mfpeticco/joga-neck/images/joga_neck_render_back.png

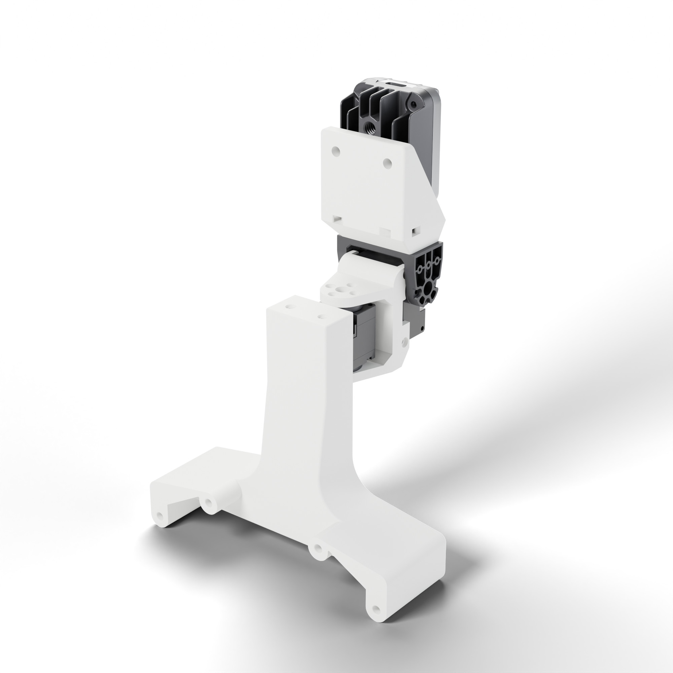
images/joga_neck_render_back.png
