mfpeticco/joga-neck/images/joga_neck_render_side.png

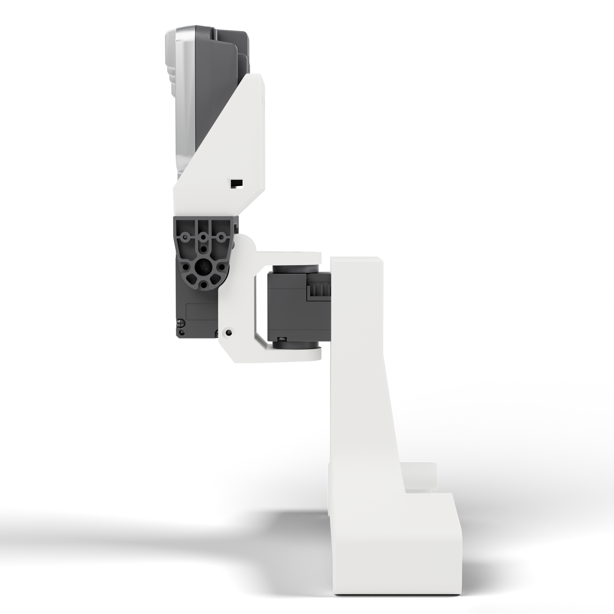
images/joga_neck_render_side.png
