mfpeticco/joga-neck/unitree/images/joga_neck_unitree_render_back.png

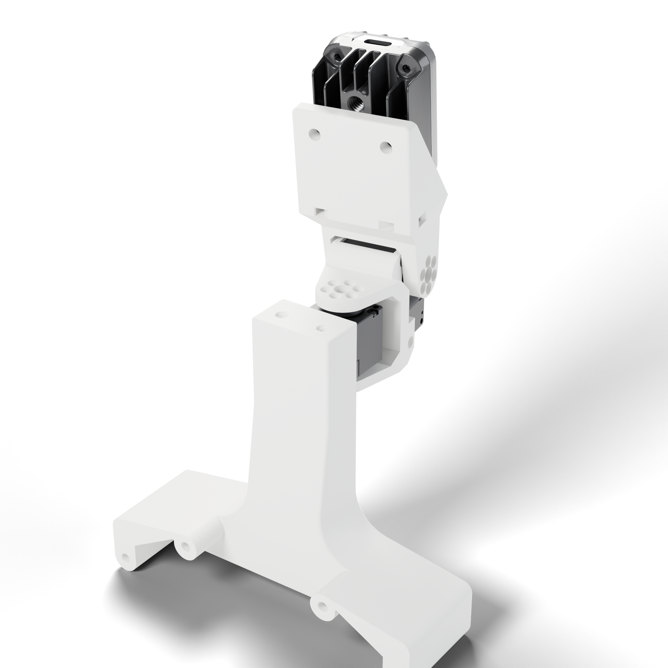
unitree/images/joga_neck_unitree_render_back.png
