mfpeticco/joga-neck/BOM.md

# Bill of Materials

Quantities are for one neck.

## Purchased parts

| Qty | Part | Notes |
|---:|---|---|
| 2 | [DYNAMIXEL XC330-M288-T](https://www.robotis.us/dynamixel-xc330-m288-t/) | Yaw and pitch servos, 5 V |
| 1 | [ROBOTIS U2D2](https://www.robotis.us/u2d2/) | USB interface for the servos |
| 1 | [U2D2 Power Hub Board](https://www.robotis.us/u2d2-power-hub-board-set/) | Powers the servo bus |
| 1 | [DROK 12 V to 5 V converter](https://www.amazon.com/dp/B0D141CZMZ) | Steps the G1's 12 V down to 5 V |
| 1 | [Luxonis OAK-1 W](https://shop.luxonis.com/products/oak-1-w) | Camera |
| 1 | [Locking USB-C cable](https://www.amazon.com/dp/B0DCNFS6F2) | Camera to your computer |
| 1 | USB cable | U2D2 to your computer |
| 2 | DYNAMIXEL 3-pin cables | Power Hub to yaw servo, yaw servo to pitch servo |
| 1 | XT30 male plug or pigtail | G1 12 V port |
| ~1 m | 16–18 AWG silicone wire | Power runs |

## Printed parts

| Qty | Part | File |
|---:|---|---|
| 1 | Torso Mount | [`torso_mount.stl`](stl/torso_mount.stl) |
| 1 | Yaw-Pitch Bracket | [`yaw_pitch_bracket.stl`](stl/yaw_pitch_bracket.stl) |
| 1 | Output Bracket | [`output_bracket.stl`](stl/output_bracket.stl) |
| 1 | Camera Mount | [`camera_mount.stl`](stl/camera_mount.stl) |

## Fasteners

| Qty | Fastener | Where |
|---:|---|---|
| As needed | M2 screws (included with the servos) | Servos and horns to the printed parts, Output Bracket to Camera Mount |
| 2 | M4 × 10 mm | OAK-1 W to the Camera Mount |
