mfpeticco/joga-neck/dynamixel/urdf/g1/assets/left_foot_hull.obj

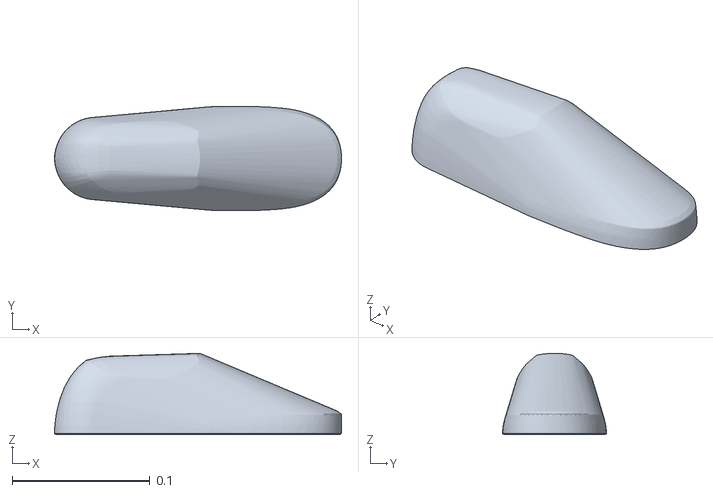
[picture p8: CAD file, 2026-11-08]
dynamixel/urdf/g1/assets/left_foot_hull.obj
0.208 x 0.0756 x 0.059
