mfpeticco/joga-neck/dynamixel/urdf/meshes/output_bracket.stl

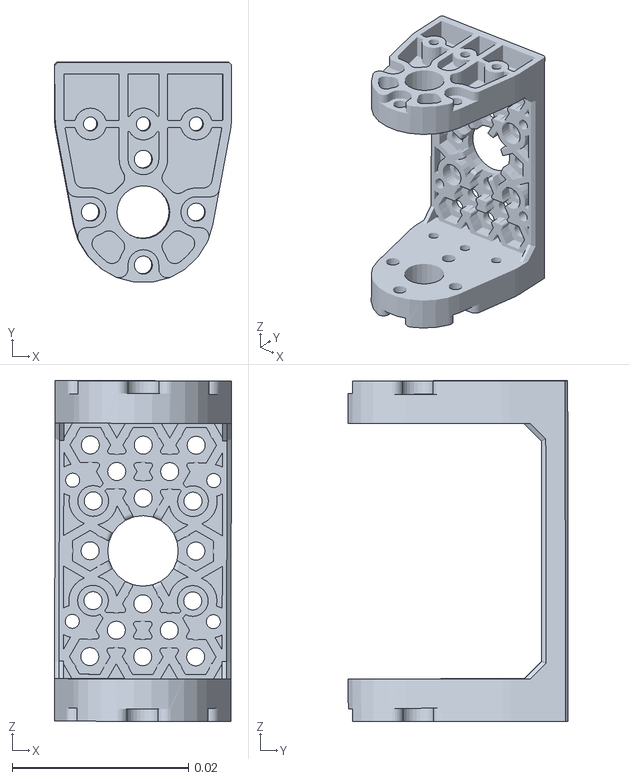
[picture p9: CAD file, 2026-11-08]
dynamixel/urdf/meshes/output_bracket.stl
0.0201 x 0.025 x 0.0387
