mfpeticco/joga-neck/unitree/urdf/meshes/_609_00001_ADHESIVE.stl

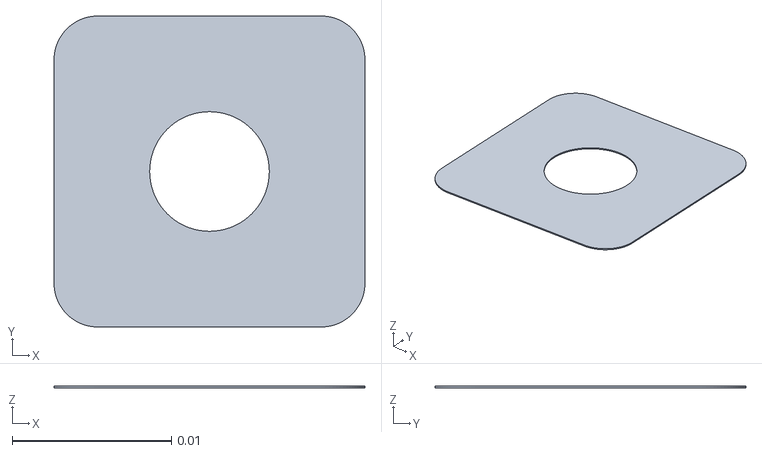
[picture p13: CAD file, 2026-11-08]
unitree/urdf/meshes/_609_00001_ADHESIVE.stl
0.0195 x 0.0195 x 0.0001
