mfpeticco/joga-neck/urdf/meshes/B3B_EH.stl

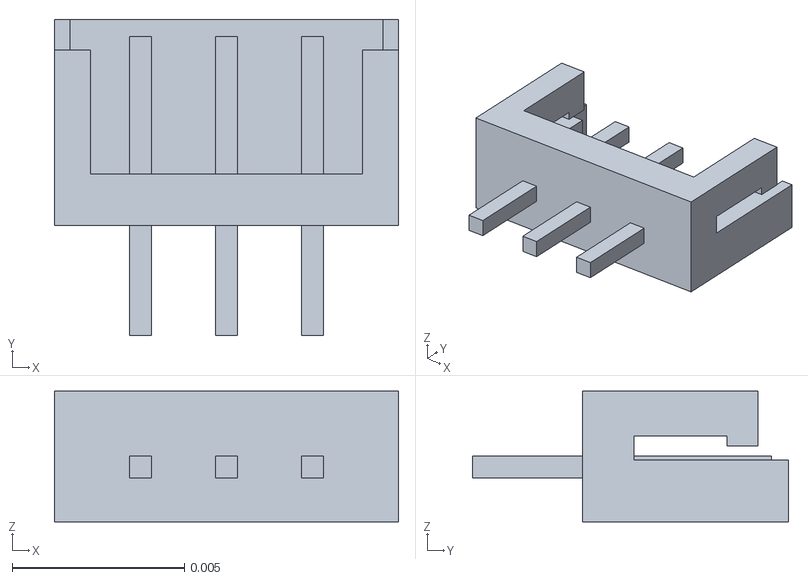
[picture p14: CAD file, 2026-10-20]
urdf/meshes/B3B_EH.stl
0.01 x 0.0092 x 0.0038
