mfpeticco/joga-neck/dynamixel/stl/torso_mount.stl

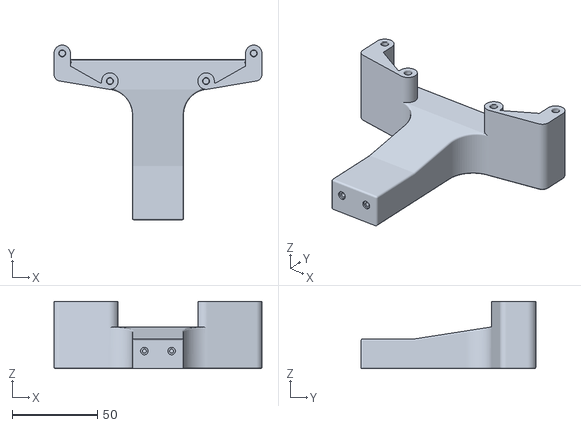
[picture p15: CAD file, 2026-11-08]
dynamixel/stl/torso_mount.stl
122.2 x 102.7 x 39.5
