mfpeticco/joga-neck/dynamixel/urdf/meshes/_609_00001_LENS.stl

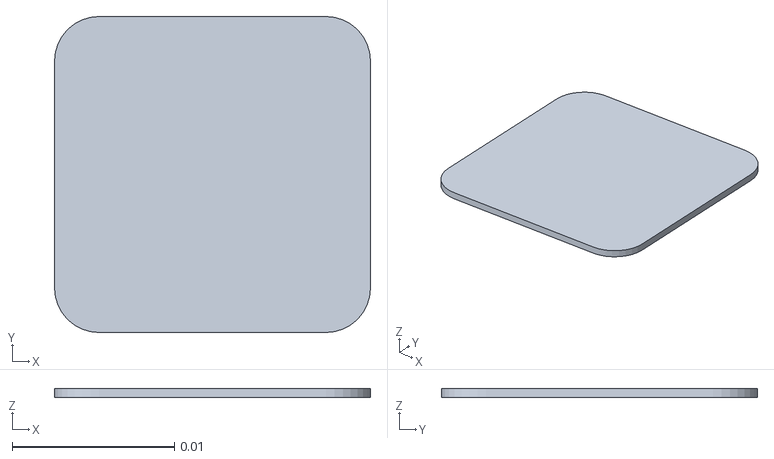
[picture p16: CAD file, 2026-11-08]
dynamixel/urdf/meshes/_609_00001_LENS.stl
0.0195 x 0.0195 x 0.00056
