mfpeticco/joga-neck/stl/output_bracket.stl

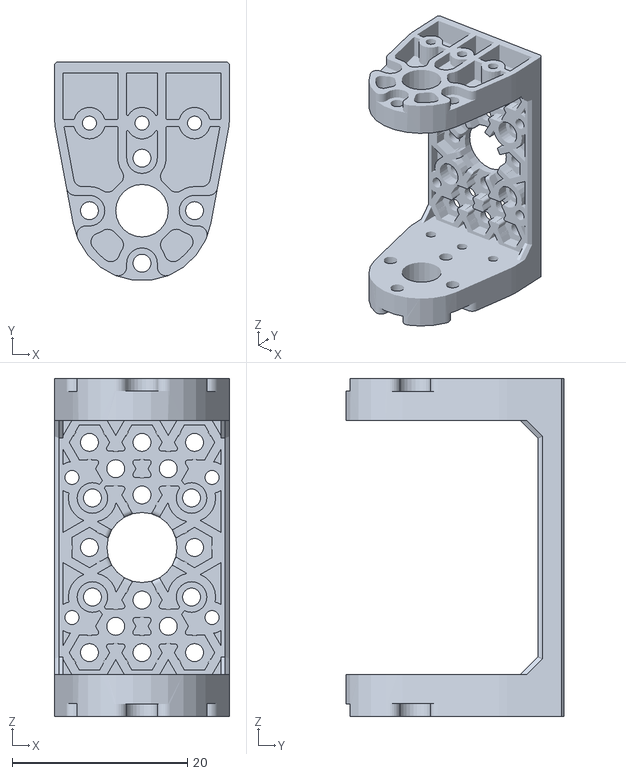
[picture p17: CAD file, 2026-10-20]
stl/output_bracket.stl
20.0 x 24.9 x 38.6
