mfpeticco/joga-neck/unitree/urdf/meshes/_606_00002_REV3.stl

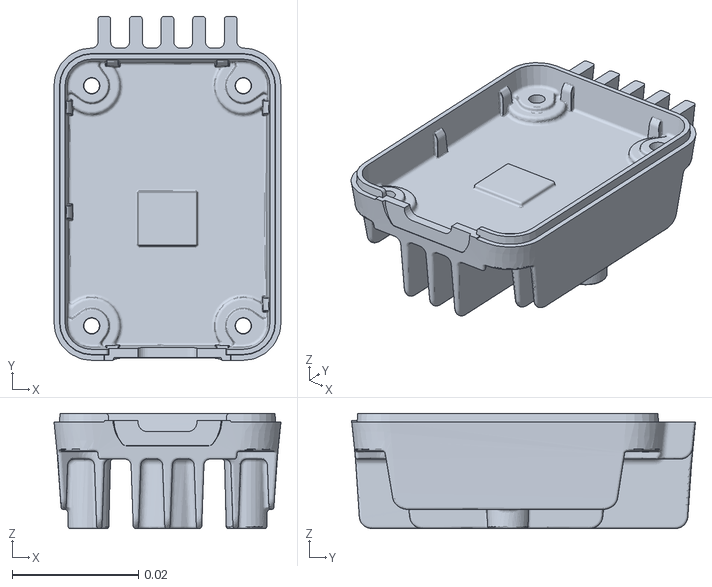
[picture p19: CAD file, 2026-11-08]
unitree/urdf/meshes/_606_00002_REV3.stl
0.0359 x 0.0545 x 0.0182
