mfpeticco/joga-neck/urdf/meshes/PHS_1_7X20_5_DC10.stl

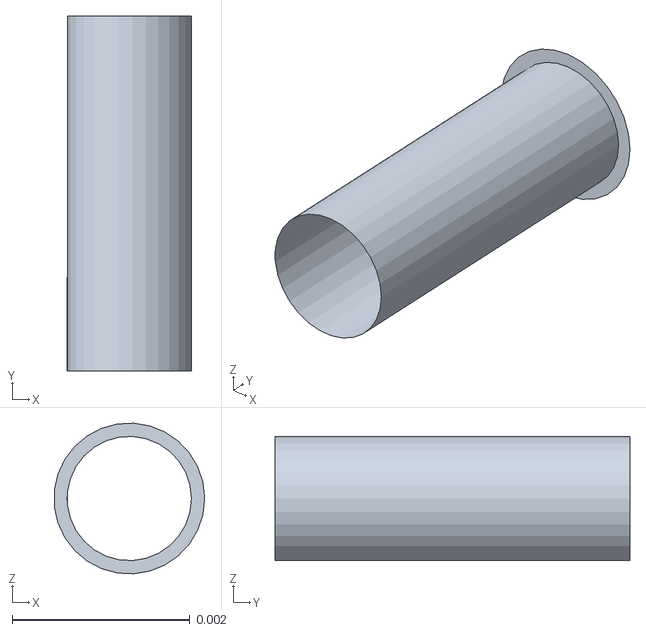
[picture p20: CAD file, 2026-10-20]
urdf/meshes/PHS_1_7X20_5_DC10.stl
0.0017 x 0.004 x 0.0017
