mfpeticco/joga-neck/dynamixel/urdf/meshes/_606_00001_REV3.stl

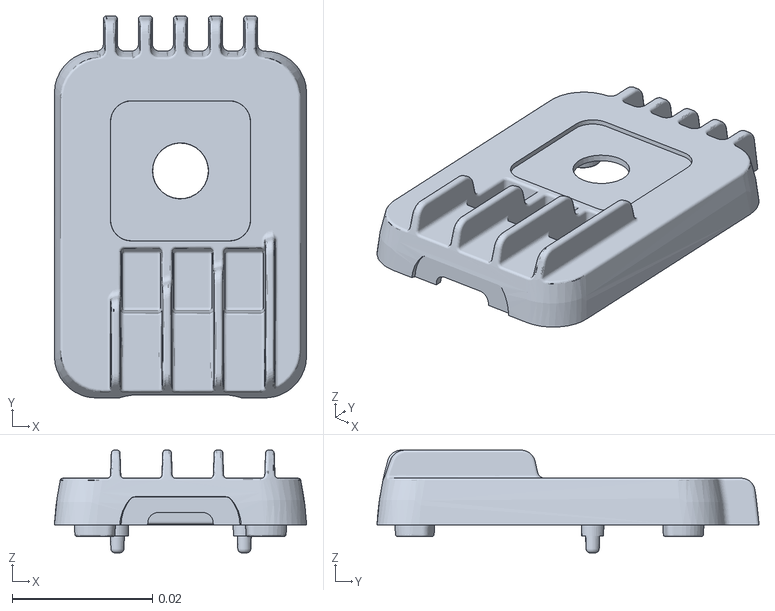
[picture p21: CAD file, 2026-11-08]
dynamixel/urdf/meshes/_606_00001_REV3.stl
0.036 x 0.0545 x 0.0147
