mfpeticco/joga-neck/urdf/meshes/yaw_pitch_bracket.stl

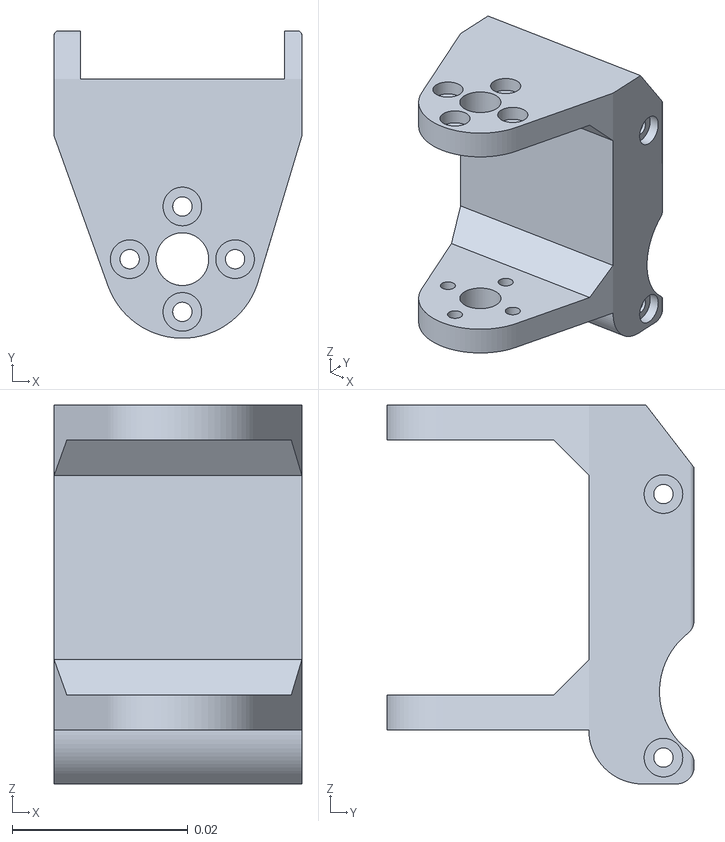
[picture p24: CAD file, 2026-10-20]
urdf/meshes/yaw_pitch_bracket.stl
0.0282 x 0.035 x 0.0431
