mfpeticco/joga-neck/dynamixel/urdf/meshes/DC15_A01_HORN_DUMMY.stl

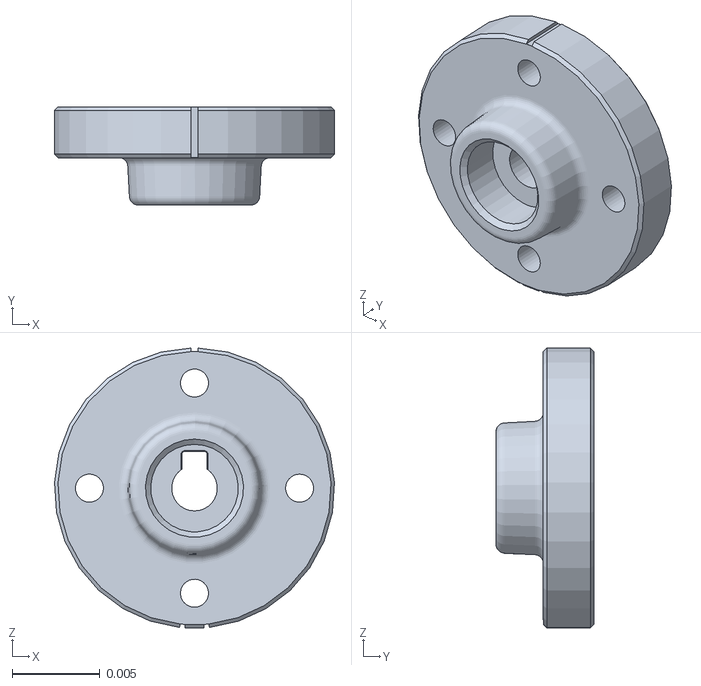
[picture p25: CAD file, 2026-11-08]
dynamixel/urdf/meshes/DC15_A01_HORN_DUMMY.stl
0.016 x 0.0056 x 0.016
