mfpeticco/joga-neck/urdf/meshes/DC15_A01_LED_CAP2_DUMMY.stl

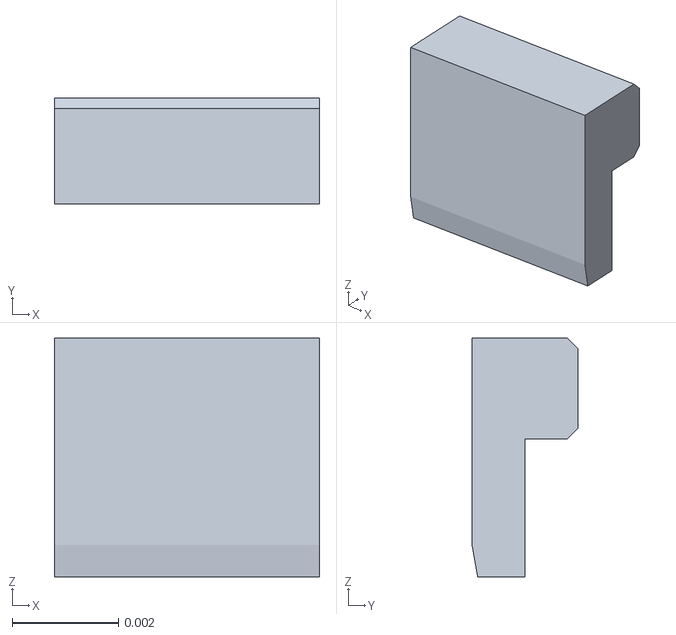
[picture p26: CAD file, 2026-10-20]
urdf/meshes/DC15_A01_LED_CAP2_DUMMY.stl
0.005 x 0.002 x 0.0045
