mfpeticco/joga-neck/urdf/meshes/PHS_1_7X20_5_DC10_1.stl

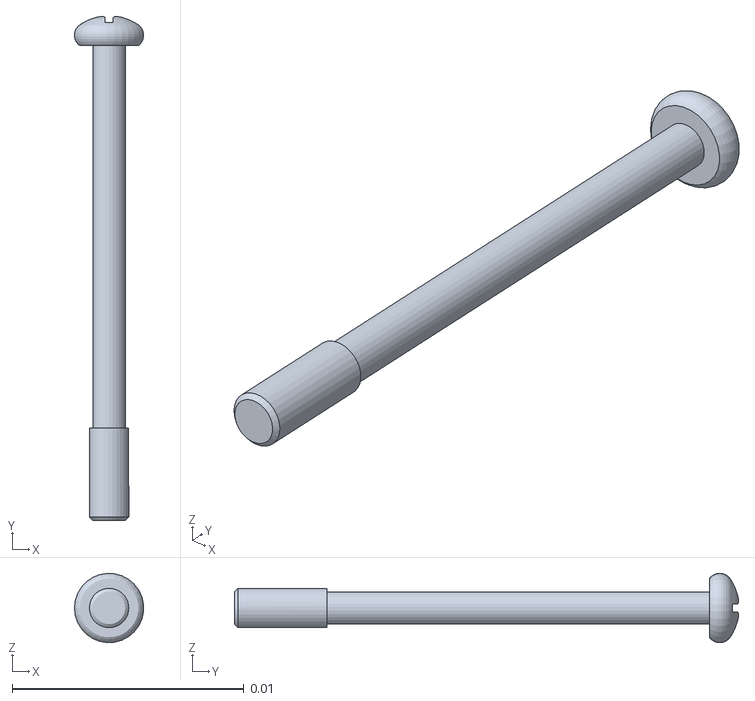
[picture p29: CAD file, 2026-10-20]
urdf/meshes/PHS_1_7X20_5_DC10_1.stl
0.00299 x 0.0218 x 0.00299
