mfpeticco/joga-neck/urdf/meshes/DC15_A01_CASE_B_DUMMY.stl

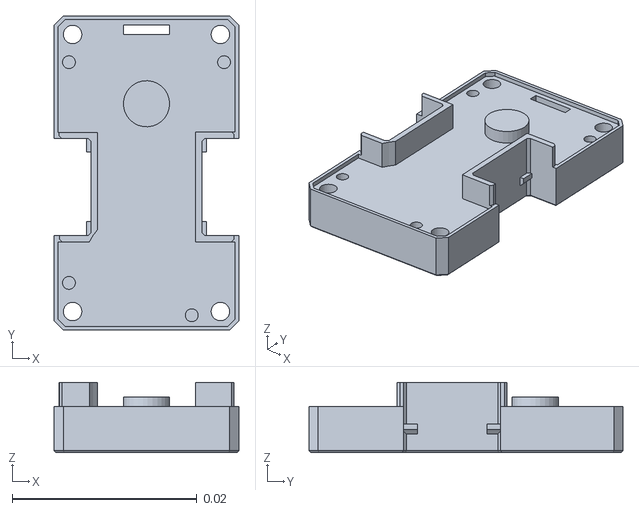
[picture p31: CAD file, 2026-10-20]
urdf/meshes/DC15_A01_CASE_B_DUMMY.stl
0.02 x 0.034 x 0.0076
