mfpeticco/joga-neck/dynamixel/urdf/meshes/BTS2_M2_6X8_1.stl

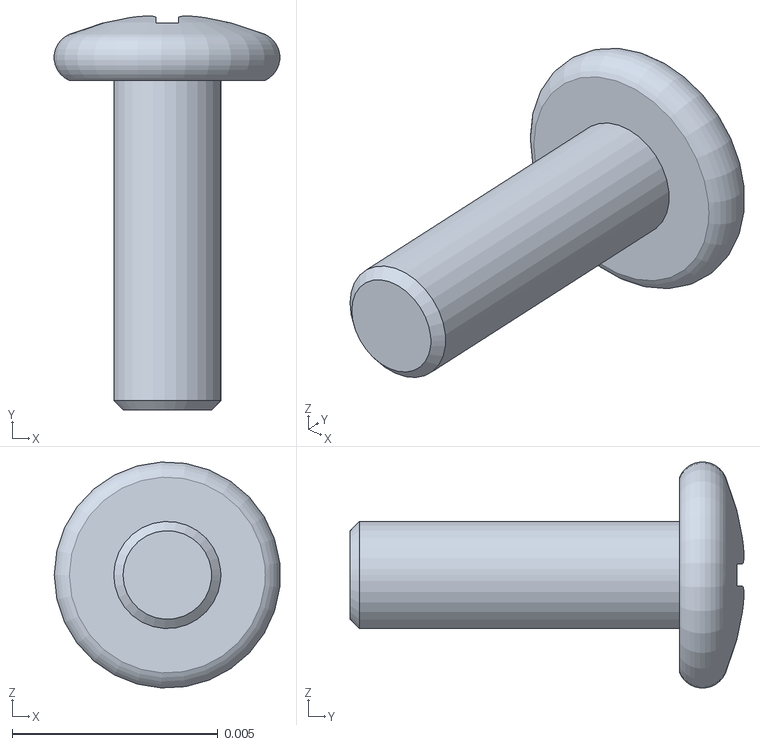
[picture p32: CAD file, 2026-11-08]
dynamixel/urdf/meshes/BTS2_M2_6X8_1.stl
0.00548 x 0.00957 x 0.00549
