mfpeticco/joga-neck/unitree/urdf/meshes/unitree_j288.stl

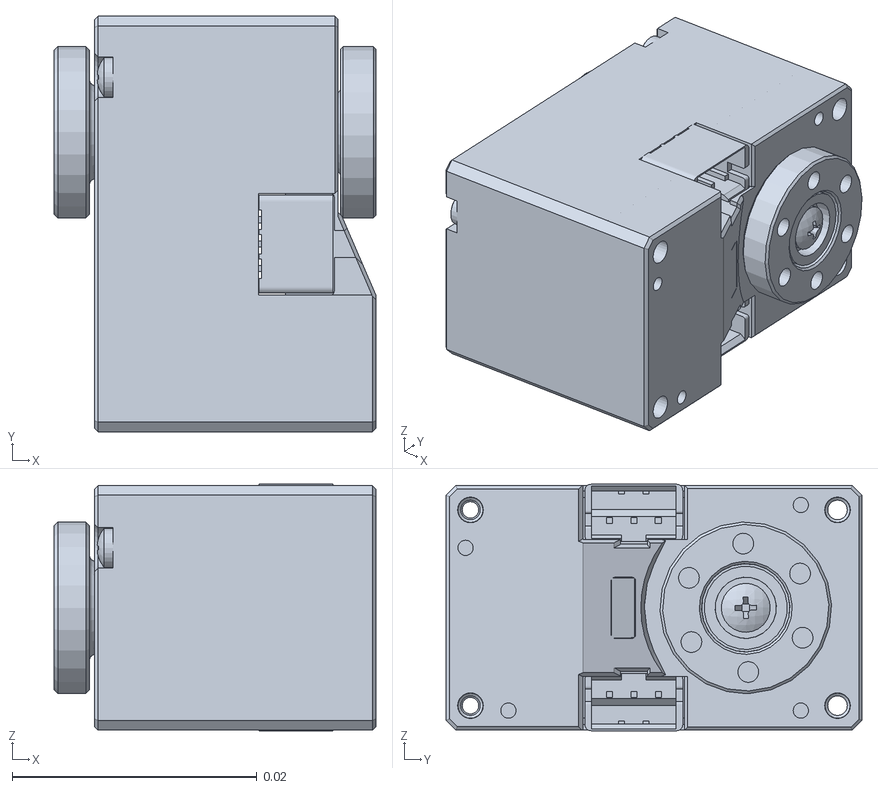
[picture p33: CAD file, 2026-11-08]
unitree/urdf/meshes/unitree_j288.stl
0.0263 x 0.034 x 0.0202
