mfpeticco/joga-neck/dynamixel/urdf/meshes/BTS2_M2_6X8.stl

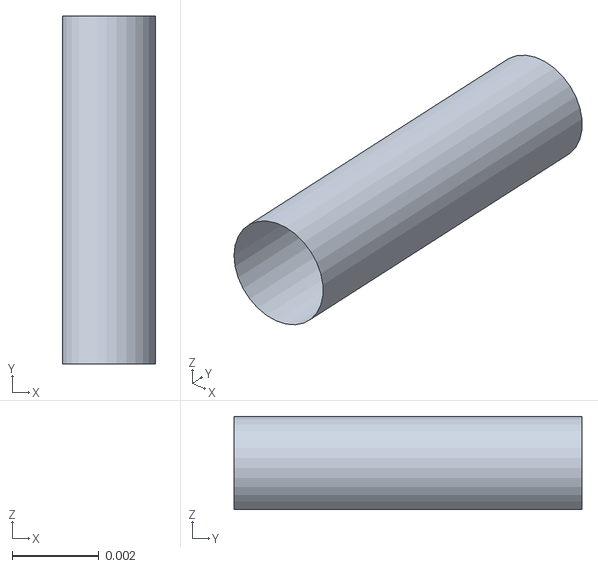
[picture p35: CAD file, 2026-11-08]
dynamixel/urdf/meshes/BTS2_M2_6X8.stl
0.00214 x 0.008 x 0.00215
