mfpeticco/joga-neck/urdf/meshes/DC15_A01_CASE_M_DUMMY.stl

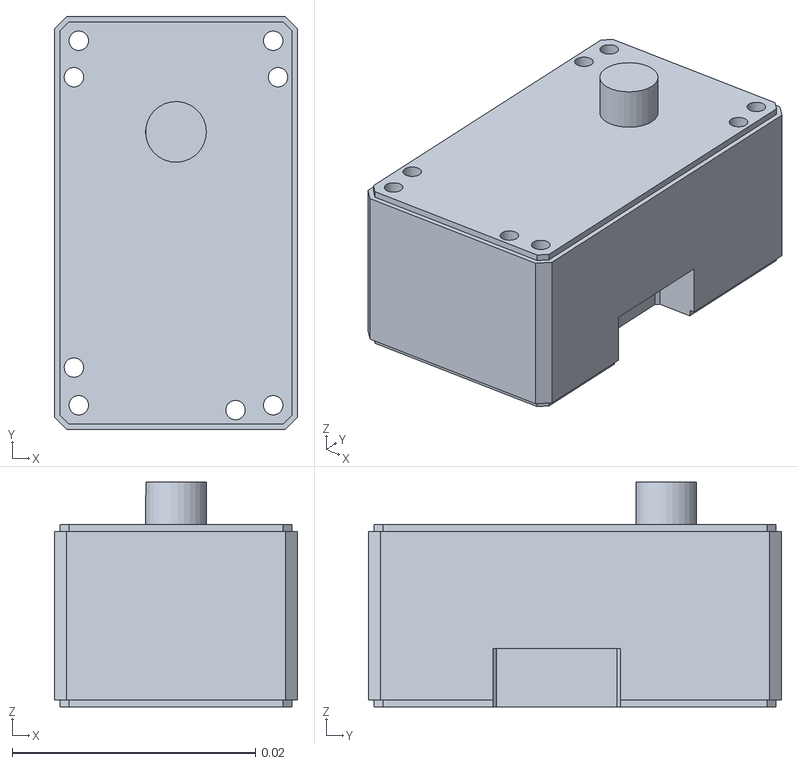
[picture p36: CAD file, 2026-10-20]
urdf/meshes/DC15_A01_CASE_M_DUMMY.stl
0.02 x 0.034 x 0.0185
