mfpeticco/joga-neck/dynamixel/urdf/meshes/DC15_A01_IDLE_CAP_DUMMY.stl

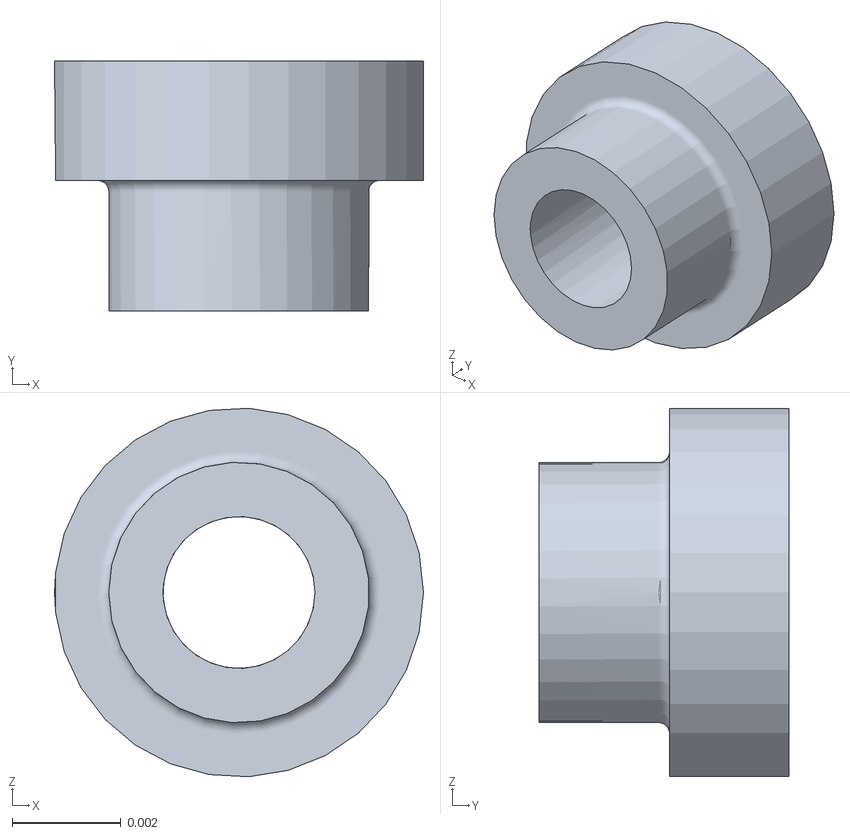
[picture p37: CAD file, 2026-11-08]
dynamixel/urdf/meshes/DC15_A01_IDLE_CAP_DUMMY.stl
0.0068 x 0.0046 x 0.00679
