mfpeticco/joga-neck/dynamixel/urdf/meshes/OakMount.stl

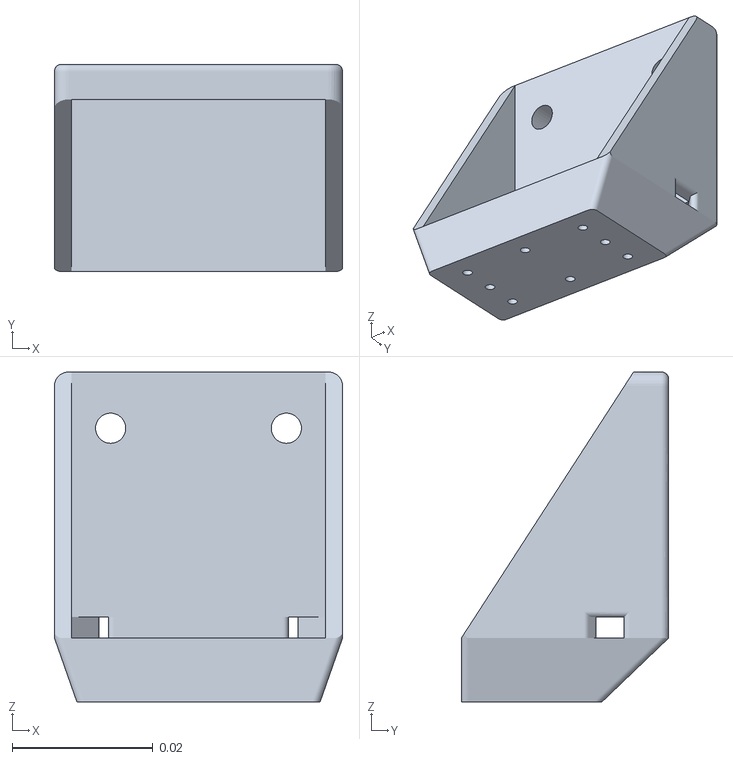
[picture p38: CAD file, 2026-11-08]
dynamixel/urdf/meshes/OakMount.stl
0.041 x 0.0295 x 0.047
