mfpeticco/joga-neck/dynamixel/urdf/meshes/DC15_A01_CASE_F_DUMMY.stl

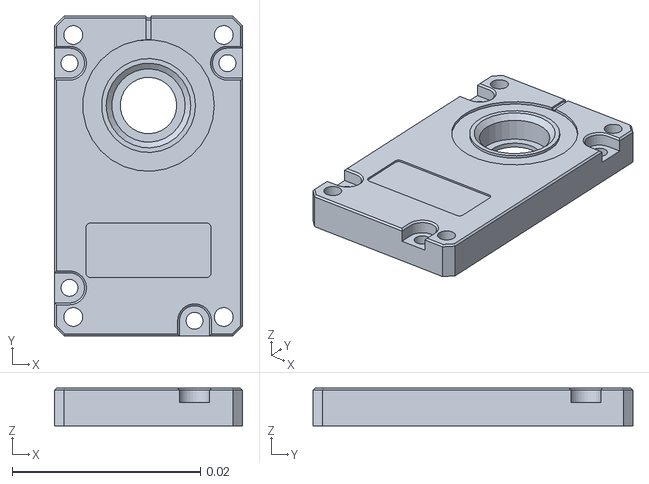
[picture p39: CAD file, 2026-11-08]
dynamixel/urdf/meshes/DC15_A01_CASE_F_DUMMY.stl
0.02 x 0.034 x 0.004
