mfpeticco/joga-neck/(list of files, cad)

Other CAD files:
unitree/urdf/g1/assets/right_foot_hull.obj
unitree/urdf/meshes/_606_00001_REV3.stl
dynamixel/urdf/meshes/_606_00002_REV3.stl
unitree/urdf/meshes/_609_00001_LENS.stl
urdf/meshes/_609_00001_ADHESIVE.stl
