mfpeticco/joga-neck/urdf/joga_neck.urdf

<?xml version="1.0" encoding="utf-8"?>
<!-- Joga Neck: 2-DoF pan-tilt camera neck for the Unitree G1 (https://joga.csail.mit.edu/neck/).
     The kinematics, camera frame, and mass properties are the model used to train the Joga policies,
     with one link per rigid body. Units: m, kg, rad.
     revolute_1 = pan (+ = look left), revolute_2 = tilt (+ = look down).
     Attach `root` to the G1 torso; g1/g1_joga_neck.xml does this at the calibrated mount pose. -->
<robot name="joga_neck">
  <mujoco>
    <compiler meshdir="meshes/" strippath="true" discardvisual="false" fusestatic="false" />
  </mujoco>
  <!-- Torso Mount and the pan (yaw) servo body. Attach this link to the G1 torso. -->
  <link name="root">
    <inertial>
      <origin xyz="-1.88947806e-06 -0.0165475179 0.0317838142" rpy="0 0 0" />
      <mass value="0.0569618527" />
      <inertia ixx="7.7620303e-05" ixy="-4.87390976e-10" ixz="5.97099333e-09" iyy="0.00010172899" iyz="2.08546722e-05" izz="4.81920637e-05" />
    </inertial>
    <visual name="b3b_eh_2">
      <origin xyz="0.00770000053 -0.0277000144 0.0674000122" rpy="1.57079367 6.32680464e-06 1.57080265" />
      <geometry>
        <mesh filename="meshes/B3B_EH.stl" />
      </geometry>
      <material name="b3b_eh_2_material">
        <color rgba="0.301961 0.301961 0.301961 1" />
      </material>
    </visual>
    <visual name="b3b_eh_3">
      <origin xyz="-0.00769999947 -0.0277001118 0.0673999713" rpy="1.57080163 -8.98039444e-06 -1.57079" />
      <geometry>
        <mesh filename="meshes/B3B_EH.stl" />
      </geometry>
      <material name="b3b_eh_3_material">
        <color rgba="0.301961 0.301961 0.301961 1" />
      </material>
    </visual>
    <visual name="bts2_m2_6x8_4">
      <origin xyz="-2.9190209e-09 -0.0366999696 0.0777000487" rpy="1.57079 -2.65358275e-06 2.65360658e-06" />
      <geometry>
        <mesh filename="meshes/BTS2_M2_6X8.stl" />
      </geometry>
      <material name="bts2_m2_6x8_4_material">
        <color rgba="0.301961 0.301961 0.301961 1" />
      </material>
    </visual>
    <visual name="bts2_m2_6x8_5">
      <origin xyz="-2.9190209e-09 -0.0366999696 0.0777000487" rpy="1.57079 -2.65358275e-06 2.65360658e-06" />
      <geometry>
        <mesh filename="meshes/BTS2_M2_6X8_1.stl" />
      </geometry>
      <material name="bts2_m2_6x8_5_material">
        <color rgba="0.301961 0.301961 0.301961 1" />
      </material>
    </visual>
    <visual name="bts2_m2_6x8_6">
      <origin xyz="0 -0.0367001415 0.0521000487" rpy="-1.57079 -7.04153879e-12 -3.14159" />
      <geometry>
        <mesh filename="meshes/BTS2_M2_6X8_1.stl" />
      </geometry>
      <material name="bts2_m2_6x8_6_material">
        <color rgba="0.301961 0.301961 0.301961 1" />
      </material>
    </visual>
    <visual name="bts2_m2_6x8_7">
      <origin xyz="0 -0.0367001415 0.0521000487" rpy="-1.57079 -7.04153879e-12 -3.14159" />
      <geometry>
        <mesh filename="meshes/BTS2_M2_6X8.stl" />
      </geometry>
      <material name="bts2_m2_6x8_7_material">
        <color rgba="0.301961 0.301961 0.301961 1" />
      </material>
    </visual>
    <visual name="dc15_a01_case_b_dummy_1">
      <origin xyz="0 -0.0367 0.0765000597" rpy="3.14159 0 0" />
      <geometry>
        <mesh filename="meshes/DC15_A01_CASE_B_DUMMY.stl" />
      </geometry>
      <material name="dc15_a01_case_b_dummy_1_material">
        <color rgba="0.301961 0.301961 0.301961 1" />
      </material>
    </visual>
    <visual name="dc15_a01_case_f_dummy_1">
      <origin xyz="0 -0.0367000517 0.0570000597" rpy="3.14159 0 0" />
      <geometry>
        <mesh filename="meshes/DC15_A01_CASE_F_DUMMY.stl" />
      </geometry>
      <material name="dc15_a01_case_f_dummy_1_material">
        <color rgba="0.301961 0.301961 0.301961 1" />
      </material>
    </visual>
    <visual name="dc15_a01_case_m_dummy_1">
      <origin xyz="0 -0.0367000517 0.0570000597" rpy="3.14159 0 0" />
      <geometry>
        <mesh filename="meshes/DC15_A01_CASE_M_DUMMY.stl" />
      </geometry>
      <material name="dc15_a01_case_m_dummy_1_material">
        <color rgba="0.301961 0.301961 0.301961 1" />
      </material>
    </visual>
    <visual name="dc15_a01_horn_dummy_1">
      <origin xyz="0 -0.0367000613 0.0534000597" rpy="-1.57079 -7.04153879e-12 -3.14159" />
      <geometry>
        <mesh filename="meshes/DC15_A01_HORN_DUMMY.stl" />
      </geometry>
      <material name="dc15_a01_horn_dummy_1_material">
        <color rgba="0.301961 0.301961 0.301961 1" />
      </material>
    </visual>
    <visual name="dc15_a01_horn_idle2_dummy_1">
      <origin xyz="0 -0.0366999865 0.0766000487" rpy="-1e-05 -2.65358275e-06 2.65360658e-06" />
      <geometry>
        <mesh filename="meshes/DC15_A01_HORN_IDLE2_DUMMY.stl" />
      </geometry>
      <material name="dc15_a01_horn_idle2_dummy_1_material">
        <color rgba="0.301961 0.301961 0.301961 1" />
      </material>
    </visual>
    <visual name="dc15_a01_idle_cap_dummy_1">
      <origin xyz="-7.16478016e-09 -0.0366999595 0.0793000487" rpy="1.57079 -2.65358275e-06 2.65360658e-06" />
      <geometry>
        <mesh filename="meshes/DC15_A01_IDLE_CAP_DUMMY.stl" />
      </geometry>
      <material name="dc15_a01_idle_cap_dummy_1_material">
        <color rgba="0.301961 0.301961 0.301961 1" />
      </material>
    </visual>
    <visual name="dc15_a01_led_cap2_dummy_1">
      <origin xyz="1.99017168e-08 -0.0441999272 0.0746001072" rpy="1e-05 -7.04153879e-12 -3.14159" />
      <geometry>
        <mesh filename="meshes/DC15_A01_LED_CAP2_DUMMY.stl" />
      </geometry>
      <material name="dc15_a01_led_cap2_dummy_1_material">
        <color rgba="0.301961 0.301961 0.301961 1" />
      </material>
    </visual>
    <visual name="phs_1_7x20_5_dc10_10">
      <origin xyz="0.00840001194 -0.0412001009 0.0550000772" rpy="-1.57079 -7.04153879e-12 -3.14159" />
      <geometry>
        <mesh filename="meshes/PHS_1_7X20_5_DC10.stl" />
      </geometry>
      <material name="phs_1_7x20_5_dc10_10_material">
        <color rgba="0.301961 0.301961 0.301961 1" />
      </material>
    </visual>
    <visual name="phs_1_7x20_5_dc10_11">
      <origin xyz="-0.00840005148 -0.0173001455 0.0549999259" rpy="-1.57079 -7.04153879e-12 -3.14159" />
      <geometry>
        <mesh filename="meshes/PHS_1_7X20_5_DC10.stl" />
      </geometry>
      <material name="phs_1_7x20_5_dc10_11_material">
        <color rgba="0.301961 0.301961 0.301961 1" />
      </material>
    </visual>
    <visual name="phs_1_7x20_5_dc10_12">
      <origin xyz="0.00489993923 -0.0138001102 0.0549999038" rpy="-1.57079 -7.04153879e-12 -3.14159" />
      <geometry>
        <mesh filename="meshes/PHS_1_7X20_5_DC10_1.stl" />
      </geometry>
      <material name="phs_1_7x20_5_dc10_12_material">
        <color rgba="0.301961 0.301961 0.301961 1" />
      </material>
    </visual>
    <visual name="phs_1_7x20_5_dc10_13">
      <origin xyz="-0.00839998806 -0.0412001455 0.0550000772" rpy="-1.57079 -7.04153879e-12 -3.14159" />
      <geometry>
        <mesh filename="meshes/PHS_1_7X20_5_DC10.stl" />
      </geometry>
      <material name="phs_1_7x20_5_dc10_13_material">
        <color rgba="0.301961 0.301961 0.301961 1" />
      </material>
    </visual>
    <visual name="phs_1_7x20_5_dc10_14">
      <origin xyz="-0.00840005148 -0.0173001455 0.0549999259" rpy="-1.57079 -7.04153879e-12 -3.14159" />
      <geometry>
        <mesh filename="meshes/PHS_1_7X20_5_DC10_1.stl" />
      </geometry>
      <material name="phs_1_7x20_5_dc10_14_material">
        <color rgba="0.301961 0.301961 0.301961 1" />
      </material>
    </visual>
    <visual name="phs_1_7x20_5_dc10_15">
      <origin xyz="0.00840001194 -0.0412001009 0.0550000772" rpy="-1.57079 -7.04153879e-12 -3.14159" />
      <geometry>
        <mesh filename="meshes/PHS_1_7X20_5_DC10_1.stl" />
      </geometry>
      <material name="phs_1_7x20_5_dc10_15_material">
        <color rgba="0.301961 0.301961 0.301961 1" />
      </material>
    </visual>
    <visual name="phs_1_7x20_5_dc10_8">
      <origin xyz="0.00489993923 -0.0138001102 0.0549999038" rpy="-1.57079 -7.04153879e-12 -3.14159" />
      <geometry>
        <mesh filename="meshes/PHS_1_7X20_5_DC10.stl" />
      </geometry>
      <material name="phs_1_7x20_5_dc10_8_material">
        <color rgba="0.301961 0.301961 0.301961 1" />
      </material>
    </visual>
    <visual name="phs_1_7x20_5_dc10_9">
      <origin xyz="-0.00839998806 -0.0412001455 0.0550000772" rpy="-1.57079 -7.04153879e-12 -3.14159" />
      <geometry>
        <mesh filename="meshes/PHS_1_7X20_5_DC10_1.stl" />
      </geometry>
      <material name="phs_1_7x20_5_dc10_9_material">
        <color rgba="0.301961 0.301961 0.301961 1" />
      </material>
    </visual>
    <visual name="torso_mount">
      <origin xyz="0 0 0" rpy="0 0 0" />
      <geometry>
        <mesh filename="meshes/torso_mount.stl" />
      </geometry>
      <material name="torso_mount_material">
        <color rgba="0.85 0.85 0.83 1" />
      </material>
    </visual>
  </link>
  <!-- Yaw bracket and the tilt (pitch) servo body. -->
  <link name="pan_link">
    <inertial>
      <origin xyz="-0.000178260303 0.0276276589 -0.0209369366" rpy="0 0 0" />
      <mass value="0.0306201227" />
      <inertia ixx="5.39959447e-06" ixy="1.30591306e-08" ixz="-9.58845652e-09" iyy="4.84621929e-06" iyz="3.82700484e-07" izz="3.71500002e-06" />
    </inertial>
    <visual name="b3b_eh">
      <origin xyz="-0.00274304069 0.0382000722 -0.019639998" rpy="2.51597799 1.5707918 -2.19639935" />
      <geometry>
        <mesh filename="meshes/B3B_EH.stl" />
      </geometry>
      <material name="b3b_eh_material">
        <color rgba="0.301961 0.301961 0.301961 1" />
      </material>
    </visual>
    <visual name="b3b_eh_1">
      <origin xyz="-0.00274290239 0.0228000722 -0.0196399414" rpy="-2.65358627e-06 -1.57079265 1.57080796" />
      <geometry>
        <mesh filename="meshes/B3B_EH.stl" />
      </geometry>
      <material name="b3b_eh_1_material">
        <color rgba="0.301961 0.301961 0.301961 1" />
      </material>
    </visual>
    <visual name="bts2_m2_6x8">
      <origin xyz="0.0125570285 0.0305001445 -0.0286399513" rpy="3.14159265 0 1.57080265" />
      <geometry>
        <mesh filename="meshes/BTS2_M2_6X8.stl" />
      </geometry>
      <material name="bts2_m2_6x8_material">
        <color rgba="0.301961 0.301961 0.301961 1" />
      </material>
    </visual>
    <visual name="bts2_m2_6x8_1">
      <origin xyz="0.0125570285 0.0305001445 -0.0286399513" rpy="3.14159265 0 1.57080265" />
      <geometry>
        <mesh filename="meshes/BTS2_M2_6X8_1.stl" />
      </geometry>
      <material name="bts2_m2_6x8_1_material">
        <color rgba="0.301961 0.301961 0.301961 1" />
      </material>
    </visual>
    <visual name="bts2_m2_6x8_2">
      <origin xyz="-0.0130429715 0.0304999797 -0.0286399414" rpy="-3.14159265 0 -1.57078735" />
      <geometry>
        <mesh filename="meshes/BTS2_M2_6X8_1.stl" />
      </geometry>
      <material name="bts2_m2_6x8_2_material">
        <color rgba="0.301961 0.301961 0.301961 1" />
      </material>
    </visual>
    <visual name="bts2_m2_6x8_3">
      <origin xyz="-0.0130429715 0.0304999797 -0.0286399414" rpy="-3.14159265 0 -1.57078735" />
      <geometry>
        <mesh filename="meshes/BTS2_M2_6X8.stl" />
      </geometry>
      <material name="bts2_m2_6x8_3_material">
        <color rgba="0.301961 0.301961 0.301961 1" />
      </material>
    </visual>
    <visual name="dc15_a01_case_b_dummy">
      <origin xyz="-0.0118429826 0.0304999902 -0.0286399642" rpy="-1.57079265 2.65358979e-06 -1.57079" />
      <geometry>
        <mesh filename="meshes/DC15_A01_CASE_B_DUMMY.stl" />
      </geometry>
      <material name="dc15_a01_case_b_dummy_material">
        <color rgba="0.301961 0.301961 0.301961 1" />
      </material>
    </visual>
    <visual name="dc15_a01_case_f_dummy">
      <origin xyz="0.00765701744 0.0305001135 -0.0286398925" rpy="-1.57079265 2.65358979e-06 -1.57079" />
      <geometry>
        <mesh filename="meshes/DC15_A01_CASE_F_DUMMY.stl" />
      </geometry>
      <material name="dc15_a01_case_f_dummy_material">
        <color rgba="0.301961 0.301961 0.301961 1" />
      </material>
    </visual>
    <visual name="dc15_a01_case_m_dummy">
      <origin xyz="0.00765701744 0.0305001135 -0.0286398925" rpy="-1.57079265 2.65358979e-06 -1.57079" />
      <geometry>
        <mesh filename="meshes/DC15_A01_CASE_M_DUMMY.stl" />
      </geometry>
      <material name="dc15_a01_case_m_dummy_material">
        <color rgba="0.301961 0.301961 0.301961 1" />
      </material>
    </visual>
    <visual name="dc15_a01_horn_dummy">
      <origin xyz="0.0112570174 0.0305001363 -0.0286398793" rpy="3.14159265 0 1.57080265" />
      <geometry>
        <mesh filename="meshes/DC15_A01_HORN_DUMMY.stl" />
      </geometry>
      <material name="dc15_a01_horn_dummy_material">
        <color rgba="0.301961 0.301961 0.301961 1" />
      </material>
    </visual>
    <visual name="dc15_a01_horn_idle2_dummy">
      <origin xyz="-0.0119429715 0.0304999895 -0.0286399513" rpy="1.57079265 0 -1.57078735" />
      <geometry>
        <mesh filename="meshes/DC15_A01_HORN_IDLE2_DUMMY.stl" />
      </geometry>
      <material name="dc15_a01_horn_idle2_dummy_material">
        <color rgba="0.301961 0.301961 0.301961 1" />
      </material>
    </visual>
    <visual name="dc15_a01_idle_cap_dummy">
      <origin xyz="-0.0146429715 0.0304999653 -0.0286399414" rpy="-3.14159265 0 -1.57078735" />
      <geometry>
        <mesh filename="meshes/DC15_A01_IDLE_CAP_DUMMY.stl" />
      </geometry>
      <material name="dc15_a01_idle_cap_dummy_material">
        <color rgba="0.301961 0.301961 0.301961 1" />
      </material>
    </visual>
    <visual name="dc15_a01_led_cap2_dummy">
      <origin xyz="-0.00994298256 0.0305000022 -0.0361398793" rpy="-1.57079265 0 1.57080265" />
      <geometry>
        <mesh filename="meshes/DC15_A01_LED_CAP2_DUMMY.stl" />
      </geometry>
      <material name="dc15_a01_led_cap2_dummy_material">
        <color rgba="0.301961 0.301961 0.301961 1" />
      </material>
    </visual>
    <visual name="phs_1_7x20_5_dc10">
      <origin xyz="0.00965705946 0.0256001262 -0.00573995132" rpy="3.14159265 0 1.57080265" />
      <geometry>
        <mesh filename="meshes/PHS_1_7X20_5_DC10.stl" />
      </geometry>
      <material name="phs_1_7x20_5_dc10_material">
        <color rgba="0.301961 0.301961 0.301961 1" />
      </material>
    </visual>
    <visual name="phs_1_7x20_5_dc10_1">
      <origin xyz="0.00965697531 0.0389001262 -0.00923995132" rpy="3.14159265 0 1.57080265" />
      <geometry>
        <mesh filename="meshes/PHS_1_7X20_5_DC10_1.stl" />
      </geometry>
      <material name="phs_1_7x20_5_dc10_1_material">
        <color rgba="0.301961 0.301961 0.301961 1" />
      </material>
    </visual>
    <visual name="phs_1_7x20_5_dc10_2">
      <origin xyz="0.00965697531 0.0389001262 -0.0331399513" rpy="3.14159265 0 1.57080265" />
      <geometry>
        <mesh filename="meshes/PHS_1_7X20_5_DC10.stl" />
      </geometry>
      <material name="phs_1_7x20_5_dc10_2_material">
        <color rgba="0.301961 0.301961 0.301961 1" />
      </material>
    </visual>
    <visual name="phs_1_7x20_5_dc10_3">
      <origin xyz="0.0096570816 0.0221001262 -0.0331399513" rpy="3.14159265 0 1.57080265" />
      <geometry>
        <mesh filename="meshes/PHS_1_7X20_5_DC10_1.stl" />
      </geometry>
      <material name="phs_1_7x20_5_dc10_3_material">
        <color rgba="0.301961 0.301961 0.301961 1" />
      </material>
    </visual>
    <visual name="phs_1_7x20_5_dc10_4">
      <origin xyz="0.00965697531 0.0389001262 -0.00923995132" rpy="3.14159265 0 1.57080265" />
      <geometry>
        <mesh filename="meshes/PHS_1_7X20_5_DC10.stl" />
      </geometry>
      <material name="phs_1_7x20_5_dc10_4_material">
        <color rgba="0.301961 0.301961 0.301961 1" />
      </material>
    </visual>
    <visual name="phs_1_7x20_5_dc10_5">
      <origin xyz="0.0096570816 0.0221001262 -0.0331399513" rpy="3.14159265 0 1.57080265" />
      <geometry>
        <mesh filename="meshes/PHS_1_7X20_5_DC10.stl" />
      </geometry>
      <material name="phs_1_7x20_5_dc10_5_material">
        <color rgba="0.301961 0.301961 0.301961 1" />
      </material>
    </visual>
    <visual name="phs_1_7x20_5_dc10_6">
      <origin xyz="0.00965697531 0.0389001262 -0.0331399513" rpy="3.14159265 0 1.57080265" />
      <geometry>
        <mesh filename="meshes/PHS_1_7X20_5_DC10_1.stl" />
      </geometry>
      <material name="phs_1_7x20_5_dc10_6_material">
        <color rgba="0.301961 0.301961 0.301961 1" />
      </material>
    </visual>
    <visual name="phs_1_7x20_5_dc10_7">
      <origin xyz="0.00965705946 0.0256001262 -0.00573995132" rpy="3.14159265 0 1.57080265" />
      <geometry>
        <mesh filename="meshes/PHS_1_7X20_5_DC10_1.stl" />
      </geometry>
      <material name="phs_1_7x20_5_dc10_7_material">
        <color rgba="0.301961 0.301961 0.301961 1" />
      </material>
    </visual>
    <visual name="yaw_pitch_bracket">
      <origin xyz="0 0 0" rpy="0 0 0" />
      <geometry>
        <mesh filename="meshes/yaw_pitch_bracket.stl" />
      </geometry>
      <material name="yaw_pitch_bracket_material">
        <color rgba="0.85 0.85 0.83 1" />
      </material>
    </visual>
  </link>
  <!-- Output bracket, Camera Mount, and the OAK-1 W camera. -->
  <link name="tilt_link">
    <inertial>
      <origin xyz="0.00172053107 0.0495976486 -0.0146574193" rpy="0 0 0" />
      <mass value="0.065958906" />
      <inertia ixx="3.03987653e-05" ixy="8.1907149e-07" ixz="-8.81518552e-08" iyy="1.2090343e-05" iyz="1.42828883e-07" izz="2.64872798e-05" />
    </inertial>
    <visual name="606_00001_rev3">
      <origin xyz="-0.00095000772 0.0561999043 -0.014501883" rpy="0.945178905 1.5707918 -2.19640906" />
      <geometry>
        <mesh filename="meshes/_606_00001_REV3.stl" />
      </geometry>
      <material name="606_00001_rev3_material">
        <color rgba="0.768627 0.886275 0.952941 1" />
      </material>
    </visual>
    <visual name="606_00002_rev3">
      <origin xyz="-0.00100000772 0.0561998781 -0.0145001029" rpy="0.945178905 1.5707918 -2.19640906" />
      <geometry>
        <mesh filename="meshes/_606_00002_REV3.stl" />
      </geometry>
      <material name="606_00002_rev3_material">
        <color rgba="0.917647 0.917647 0.917647 1" />
      </material>
    </visual>
    <visual name="609_00001_adhesive">
      <origin xyz="-0.00095000772 0.0561999143 -0.0145018836" rpy="0.945178905 1.5707918 -2.19640906" />
      <geometry>
        <mesh filename="meshes/_609_00001_ADHESIVE.stl" />
      </geometry>
      <material name="609_00001_adhesive_material">
        <color rgba="0.498039 0.498039 0.498039 1" />
      </material>
    </visual>
    <visual name="609_00001_lens">
      <origin xyz="-0.00095000772 0.0561999143 -0.0145018836" rpy="0.945178905 1.5707918 -2.19640906" />
      <geometry>
        <mesh filename="meshes/_609_00001_LENS.stl" />
      </geometry>
      <material name="609_00001_lens_material">
        <color rgba="0.972549 0.529412 0.00392157 1" />
      </material>
    </visual>
    <visual name="oakmount">
      <origin xyz="0 0.016999962 -0.0145" rpy="-3.14159265 -1.57079265 1.57079735" />
      <geometry>
        <mesh filename="meshes/OakMount.stl" />
      </geometry>
      <material name="oakmount_material">
        <color rgba="0.615686 0.811765 0.929412 1" />
      </material>
    </visual>
    <visual name="output_bracket">
      <origin xyz="0 0 0" rpy="0 0 0" />
      <geometry>
        <mesh filename="meshes/output_bracket.stl" />
      </geometry>
      <material name="output_bracket_material">
        <color rgba="0.85 0.85 0.83 1" />
      </material>
    </visual>
  </link>
  <!-- pan (yaw), + = look left -->
  <joint name="revolute_1" type="revolute">
    <parent link="root" />
    <child link="pan_link" />
    <origin xyz="0 -0.0367000796 0.0505000597" rpy="3.14159 2.65359683e-06 2.65357134e-06" />
    <axis xyz="0 0 -1" />
    <limit lower="-1.5708" upper="1.5708" effort="0.93" velocity="8.48" />
  </joint>
  <!-- tilt (pitch), + = look down -->
  <joint name="revolute_2" type="revolute">
    <parent link="pan_link" />
    <child link="tilt_link" />
    <origin xyz="0.0141570174 0.0305001547 -0.0286398793" rpy="-1.57079265 0 -1.57078735" />
    <axis xyz="0 0 1" />
    <limit lower="-0.3491" upper="1.5708" effort="0.93" velocity="8.48" />
  </joint>
  <!-- Camera optical frame on the OAK-1 W (same pose as the original camera_frame). -->
  <link name="camera_frame">
    <inertial>
      <origin xyz="0 0 0" rpy="0 0 0" />
      <mass value="1e-09" />
      <inertia ixx="1e-12" ixy="0" ixz="0" iyy="1e-12" iyz="0" izz="1e-12" />
    </inertial>
  </link>
  <joint name="camera_joint" type="fixed">
    <parent link="tilt_link" />
    <child link="camera_frame" />
    <origin xyz="-0.00883897264 0.0487498674 -0.0144588247" rpy="1.5708 -2.65360329e-06 -3.14158796" />
  </joint>
</robot>
