mfpeticco/joga-neck/(commit log)

2026-10-20 Initial release of the Joga Neck
    2-DoF yaw-pitch camera neck for the Unitree G1 from the Joga paper:
    print-ready STLs, assembly STEP, URDF with meshes and inertials, BOM,
    illustrated assembly guide, and renders. Licensed CC BY 4.0.
2026-11-08 Update the DYNAMIXEL STEP with the corrected pitch servo mate
